piotr-wiszowaty/atari_xlxe_sd_cartridge/(list of files, drawings)

Other design files:
pcb/cart.pcb
