piotr-wiszowaty/atari_xlxe_sd_cartridge/(threads)

Thread 1 (2015-02-17):

Broken symlinks in pcb/symbols

epi, 2015-02-17:
There are symbolic links in pcb/symbols that reveal some data that you would probably want to keep private. :)
These are: LPC1114FBD48-1.sym, XC95144XL-TQ100-1.sym and LM1117.sym.

Closed 2015-02-18.

Thread 2 (2024-01-01):

missing files

vwbug2007, 2024-01-01:
it is missing bom file in xls,xlsx and csv format plus csv file of centriod file... how can i build it without the info?

piotr-wiszowaty, 2024-01-01:
Added.
