piotr-wiszowaty/atari_xlxe_sd_cartridge/(commit log)

2013-08-16 Add PCB design files
    [player5v4.pcb, player5v4.sch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]
2013-08-16 Rename PCB design files
    [cart.pcb, cart.sch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]
2013-08-25 More detailed UART interface description
2013-08-29 Update device info on PCB
    [cart.pcb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]
2013-12-30 Fix 1st file cluster calculation
    [fat.c]
2013-12-30 PCB: move programming connectors away from board edge
    [cart.pcb]
2014-01-13 Shorten sample code.
2014-01-20 PCB: Add open hardware logo
    [cart.pcb]
2014-03-08 PCB: drive RD4 and RD5 from 3.3 V rail
    [cart.pcb, cart.sch]
2014-05-28 Remove the outdated Atari800 patch.
    Doesn't match current hardware.
2014-05-31 File selector: Case insensitive filenames sorting
2014-06-22 File selector: enable interrupts in test
2014-07-06 Handle SD card removals/insertions
    [cart.sch]
2014-08-17 PCB,CPLD: make RD4 and RD5 software controllable
    [cart.pcb, cart.sch]
2014-09-22 PCB: update gerber files
    [cart.bottom.gbr, cart.bottommask.gbr, cart.bottompaste.gbr, cart.fab.gbr, cart.outline.gbr, cart.top.gbr, cart.topmask.gbr, cart.toppaste.gbr]
2014-09-24 File selector v2: disable NMIs during dummy frame
2014-10-12 File selector v2: disable interrupts during com block loading
    ...all except keyboard interrupt.
    Change by Piotr Fusik.
2014-12-05 Video: --video-filter.
2014-12-05 Video: fix frame rate.
2015-02-18 PCB: Replace symlinks to symbols with actual symbols
2024-01-01 PCB: Regenerate gerber files; add BOM and centroid files
    [cart.bottom.gbr, cart.bottommask.gbr, cart.bottompaste.gbr, cart.fab.gbr, cart.outline.gbr, cart.top.gbr, cart.topmask.gbr, cart.toppaste.gbr]
